ashoksharma842/robot_arm/Schematic_robot_arm_2022-02-01.pdf

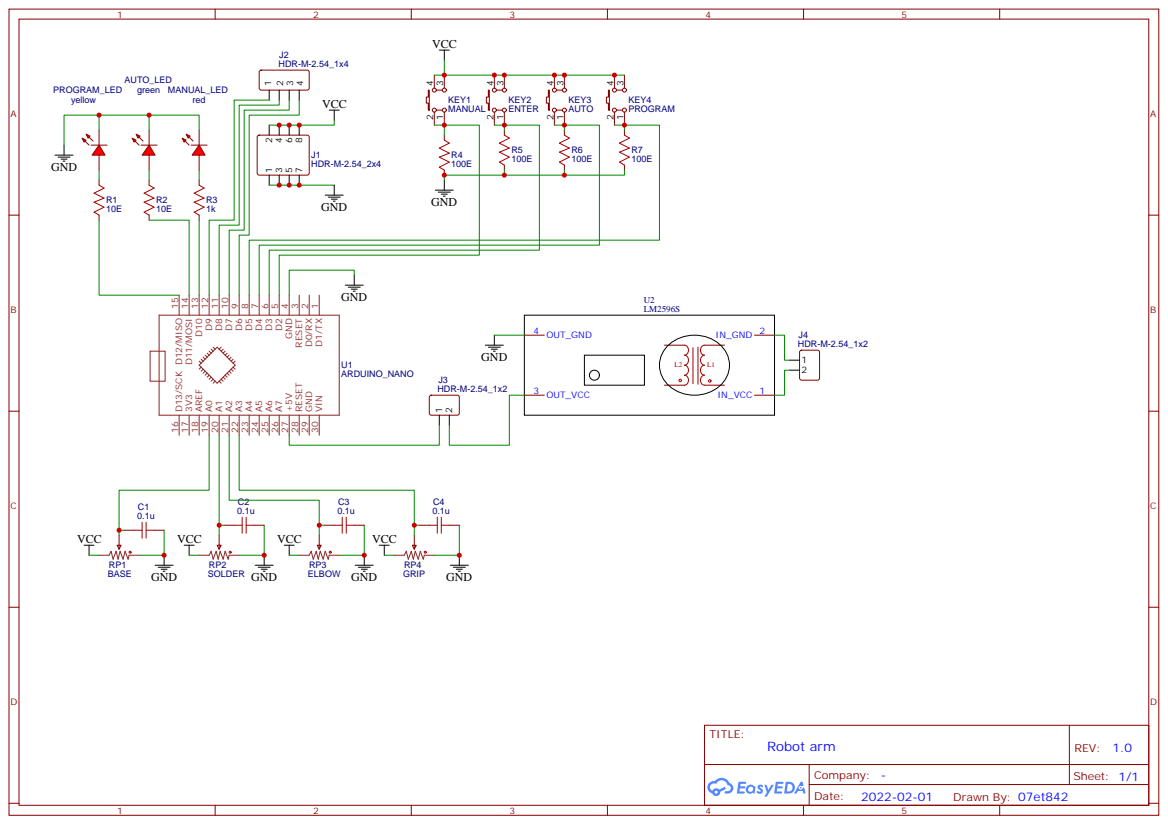
[picture p1: page 1]

1 VIN 30 GND 29 RESET 28 +5V 27 A7 26 A6 25 A5 24 A4 23 A3 22 A2 21 A1 20 A0 19 AREF 18 3V3 17 D13/SCK 16 D12/MISO 15
