ashoksharma842/robot_arm/PCB_PCB_robot_arm_2022-02-01.pdf

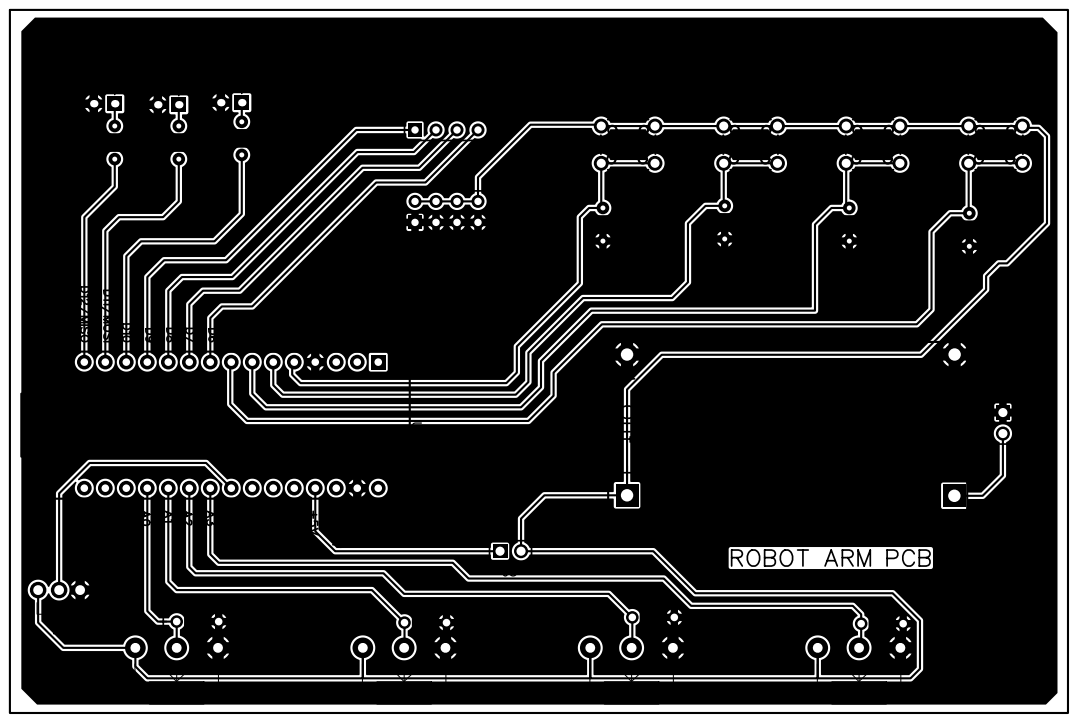
[picture p2: page 1]
