ashoksharma842/robot_arm/(list of files, drawings)

Other design files:
PCB_PCB_robot_arm_2022-02-01.json
SCH_robot_arm_2022-02-01.json
