ashoksharma842/robot_arm/(threads)

Thread 1 (2022-01-30):

The output of Potentiometer is very noisy

ashoksharma842, 2022-01-30:
We used 4 Pots of 100 kOhms in parallel from 5V to Gnd and are connected to A0,A1,A2 and A3.
Out put comes from 0 to ~900 counts only.
After 500 counts the output becomes very unstable.

ashoksharma842, 2022-01-30:
The value of 100k is too large for using it as ADC.
The higher values cause much noise.
Reduced the value to 10k. Noise reduced significantly.
The value of 900 count might be due to the parallel values of resistors!?

ashoksharma842, 2022-01-31:
the output is 1024 if external power supply is connected.
from the Arduino, the voltage provided drops to <4V.
Also the noise remains even if 10k Pots are used. (after 500 counts)

ashoksharma842, 2022-01-31:
the 5V from power supply (buck converter was provided to VIN instead of 5V.
This was causing problem.
Also added 0.1uF on all POT middle pins (to ground).
This solved all the issues.

Closed 2022-01-31.
