ashoksharma842/robot_arm/robot_arm.ino

/*
 * robot_arm
 *
 * The basic Robot arm project.
 * It takes 4 inputs from 4 Potentiometers and moves 4 servo motors accordingly
 * It works in 3 modes : AUTO, MANUAL and PROGRAM
 * Modes are changed using 3 push buttons, and indicated by LEDs
 * In MANUAL mode servos move wrt potentiometer
 * PROGRAM mode is activated by long press of program button in Manual mode
 * In PROGRAM mode, program is saved using Enter button
 * In AUTO mode, the saved program is run in a loop with some delay.
 *
 * https://github.com/ashoksharma842/robot_arm
 */
#include <Servo.h>
#include <EEPROM.h>
#include<NoDelay.h>

Servo myservo[4];
enum eSERVO {GRIP_SERVO = 6, ELBOW_SERVO, SHOULDER_SERVO, BASE_SERVO};
enum eLED {MANUAL_LED = 10, AUTO_LED, PROGRAM_LED};
enum eBUTTONS {MANUAL_BUTTON = 2, ENTER_BUTTON, AUTO_BUTTON, PROGRAM_BUTTON};
enum eADC_DATA {BASE = 0, SHOULDER, ELBOW, GRIP};
volatile int ADC_values[4] = {0};
int prev_ADC_values[4] = {0};
enum eOPERATING_MODE{MANUAL_MODE = 0, AUTO_MODE, PROGRAM_MODE};
int operatingMode = MANUAL_MODE, prevOperatingMode = MANUAL_MODE;
unsigned int avg = 0;
const unsigned int maxADCval = 1023; //check the max value of ADC

// Variables for long press of programming mode:
int lastState = LOW;
enum eButtonStae {ePRESSED = 1, eUNPRESSED = 2};
int currentState;
unsigned long pressedTime  = 0;
unsigned long releasedTime = 0;
const int SHORT_PRESS_TIME = 1000; // 1 second
int read_addr = 1;
int addr = 1;
int total_steps = 0;
int EEPROM_Space = 0;
int programCopy[100] = {0};

//  to eliminate delay
void SetMotorStatus();
noDelay Delaytime(1000, SetMotorStatus);
int delayState = 0;

void setup() {
  Serial.begin(9600);
  pinMode(MANUAL_LED, OUTPUT);
  pinMode(AUTO_LED, OUTPUT);
  pinMode(PROGRAM_LED, OUTPUT);
  pinMode(MANUAL_BUTTON, INPUT);
  pinMode(ENTER_BUTTON, INPUT);
  pinMode(AUTO_BUTTON, INPUT);
  pinMode(PROGRAM_BUTTON, INPUT);
  attachInterrupt(digitalPinToInterrupt(ENTER_BUTTON),EnterButtonPressed,RISING);
  attachInterrupt(digitalPinToInterrupt(MANUAL_BUTTON),ManualButtonPressed,RISING);
  EEPROM_Space = EEPROM.length();
  total_steps = EEPROM.read(0);
  if(total_steps > 0){
    Serial.print("programmed step number : ");Serial.println((total_steps-1)/4);
    while(read_addr < total_steps){
      for(int i = 0; i < 4; i++){
        programCopy[read_addr + i] = EEPROM.read(read_addr + i);
        Serial.print("[");Serial.print(programCopy[read_addr + i]);Serial.print("]");
      }
      read_addr +=4;
      Serial.print("\n");
    }
  } else {
    Serial.println("robot not programmed");
  }
  MoveArmManually();
  myservo[GRIP].attach(GRIP_SERVO);
  myservo[ELBOW].attach(ELBOW_SERVO);
  myservo[SHOULDER].attach(SHOULDER_SERVO);
  myservo[BASE].attach(BASE_SERVO);
}

void loop() {
  operatingMode = GetOperatingMode();
  OperatingModeIndication(operatingMode);

  if((operatingMode == MANUAL_MODE) || (operatingMode == PROGRAM_MODE)){
    MoveArmManually();
  }
  if(operatingMode == AUTO_MODE){
    MoveArmFromProgrammedLocations();
  }
}

void SetMotorStatus()
{
  delayState = 1;
}

void MoveSmoothly(Servo servoMotor, int servoPosition)
{
  int delaytime = 10;
  int initPosition = servoMotor.read();
  if(initPosition < servoPosition){
    for(int i = initPosition; i < servoPosition; i++){
      servoMotor.write(i);
      delay(delaytime);
    }
  }else{
    for(int i = initPosition; i > servoPosition; i--){
      servoMotor.write(i);
      delay(delaytime);
    }
  }
}

void ManualButtonPressed()
{
  operatingMode = MANUAL_MODE;
}

void EnterButtonPressed()
{
  if(operatingMode == PROGRAM_MODE){
    for(int i = 0; i < 4; i++){
      EEPROM.write(addr + i, map(ADC_values[i], 0, maxADCval, 0, 180));
      Serial.print("[");Serial.print(map(ADC_values[i], 0, maxADCval, 0, 180));Serial.print("]");
    }
    addr += 4;//4 positions of servos written
    EEPROM.write(0, addr);//store the numbers of steps on address 0
    Serial.print("->");Serial.println((addr-1)/4);
  }
}

void MoveArmFromProgrammedLocations(void)
{
  read_addr = 1;
  while(read_addr < total_steps){
    for(int i = 0; i < 4;){
      if(delayState){
        MoveSmoothly(myservo[i],(programCopy[read_addr + i]));
        Serial.print("[");Serial.print(programCopy[read_addr + i]);Serial.print("]");
        if(i==3)Serial.print("\n");
        delayState = 0;
        i++;
      }
      if(operatingMode != AUTO_MODE)return;
      Delaytime.update();
    }
    read_addr +=4;
  }
}

void MoveArmManually(void)
{
  for(int i = 0; i < 4; i++){
    for(int j = 0; j < 10; j++){
      avg += analogRead(i);
    }
    ADC_values[i] = avg/10;
    if(memcmp(prev_ADC_values, ADC_values, sizeof(ADC_values)) != 0){
      MoveSmoothly(myservo[i],(map(ADC_values[i], 0, maxADCval, 0, 180)));
      memcpy(prev_ADC_values, ADC_values, sizeof(ADC_values));
    }
    avg = 0;
  }
}

int GetOperatingMode(void)
{
  if((digitalRead(MANUAL_BUTTON) == HIGH) && (prevOperatingMode != MANUAL_MODE)){
    prevOperatingMode = MANUAL_MODE;
    Serial.println("MANUAL_MODE");
    return MANUAL_MODE;
  }
  if((digitalRead(AUTO_BUTTON) == HIGH) && (prevOperatingMode != AUTO_MODE)){
    prevOperatingMode = AUTO_MODE;
    Serial.println("AUTO_MODE");
    return AUTO_MODE;
  }
  // Press and hold for 3s for programming mode in MANUAL mode.
  if((operatingMode == MANUAL_MODE) && (prevOperatingMode != PROGRAM_MODE)){
    if((digitalRead(PROGRAM_BUTTON) == HIGH) && (lastState == LOW)){// button is pressed
      pressedTime = millis();
      currentState = ePRESSED;
    }else if((digitalRead(PROGRAM_BUTTON) == LOW) &&(lastState == HIGH) && (currentState == ePRESSED)){// button is released
      releasedTime = millis();
      currentState = eUNPRESSED;
      long pressDuration = releasedTime - pressedTime;
      if( pressDuration > SHORT_PRESS_TIME ){
        prevOperatingMode = PROGRAM_MODE;
        pressDuration = 0;
        Serial.println("PROGRAM_MODE");
        return PROGRAM_MODE;
      }
    }
    lastState = digitalRead(PROGRAM_BUTTON);
  }
}

void OperatingModeIndication(int mode)
{
   switch(mode){
     case(MANUAL_MODE): {
      digitalWrite(MANUAL_LED, HIGH);
      digitalWrite(AUTO_LED, LOW);
      digitalWrite(PROGRAM_LED, LOW);
      break;
    }
    case(AUTO_MODE): {
      digitalWrite(MANUAL_LED, LOW);
      digitalWrite(AUTO_LED, HIGH);
      digitalWrite(PROGRAM_LED, LOW);
      break;
    }
    case(PROGRAM_MODE): {
      digitalWrite(MANUAL_LED, LOW);
      digitalWrite(AUTO_LED, LOW);
      digitalWrite(PROGRAM_LED, HIGH);
      break;
    }
   }
}
