ashoksharma842/robot_arm/(commit log)

2022-01-30 added leds and push buttons to Arduino
2022-01-30 added one servo motor
2022-01-30 added four servo motors
2022-01-31 added functionality for all servo motors
2022-01-31 added operating mode switching functionality
2022-01-31 enter button attached to interrupt
2022-01-31 added auto mode functionality and added manual button to intterupt
2022-02-01 motors now move smoothly
2022-02-01 motor now starts from the positions specified by Pots instead of 90degrees
2022-02-01 don't move motors if the state is not changed
2022-02-01 added schematic file
2022-02-01 added easyEDA file
    [SCH_robot_arm_2022-02-01.json]
2022-02-01 added gerber and PCB files
    [PCB_PCB_robot_arm_2022-02-01.json]
